PiStorm/cm4board/README.md

# CM4 Adapter for PiStorm32-Lite and PiStorm

This repository contains the hardware design for RaspberryPi Compute Module 4 Adapter designed especially for PiStorm32-Lite and PiStorm32 Amiga accelerators. Please note the CM4 adapter for PiStorm is not ready yet, only the PiStorm32-Lite version is usable.
