PiStorm/cm4board/CM4_PiStorm32Lite/FabricationData/PiStorm32L_IO_Trapdoor.stl

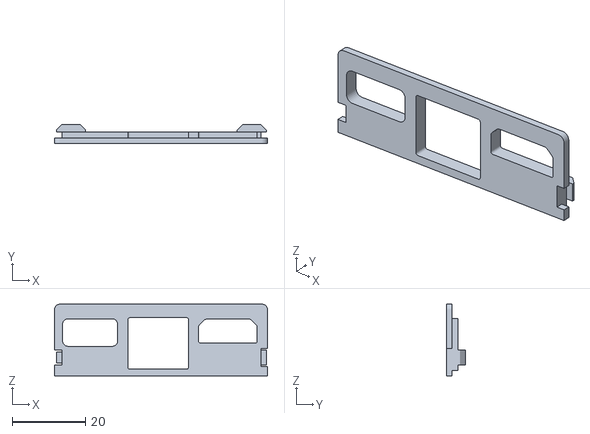
[picture p5: CAD file, 2024-01-28]
CM4_PiStorm32Lite/FabricationData/PiStorm32L_IO_Trapdoor.stl
58.0 x 5.15 x 19.5
