PiStorm/cm4board/CM4_PiStorm32Lite/FabricationData/CM4_PiStorm32Lite_Spacer.stl

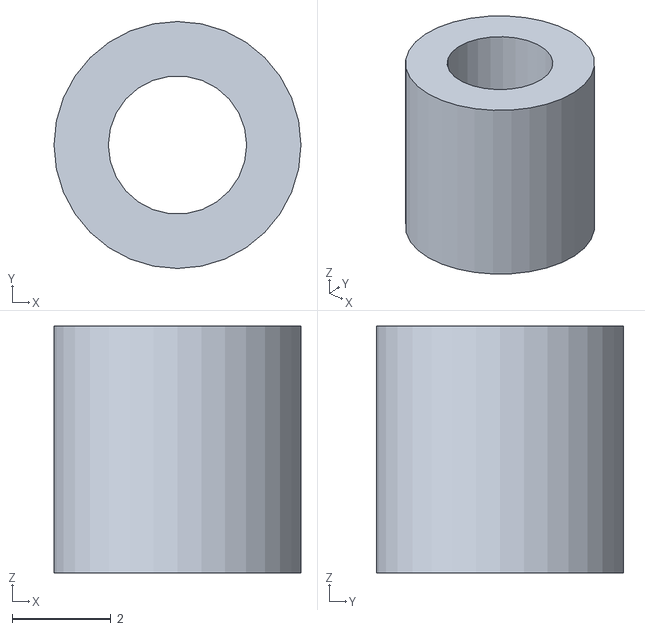
[picture p6: CAD file, 2023-03-12]
CM4_PiStorm32Lite/FabricationData/CM4_PiStorm32Lite_Spacer.stl
5.00 x 5.00 x 5.00
