PiStorm/cm4board/CM4_PiStorm32Lite/FabricationData/CM4_PiStorm32Lite_Schematic.pdf

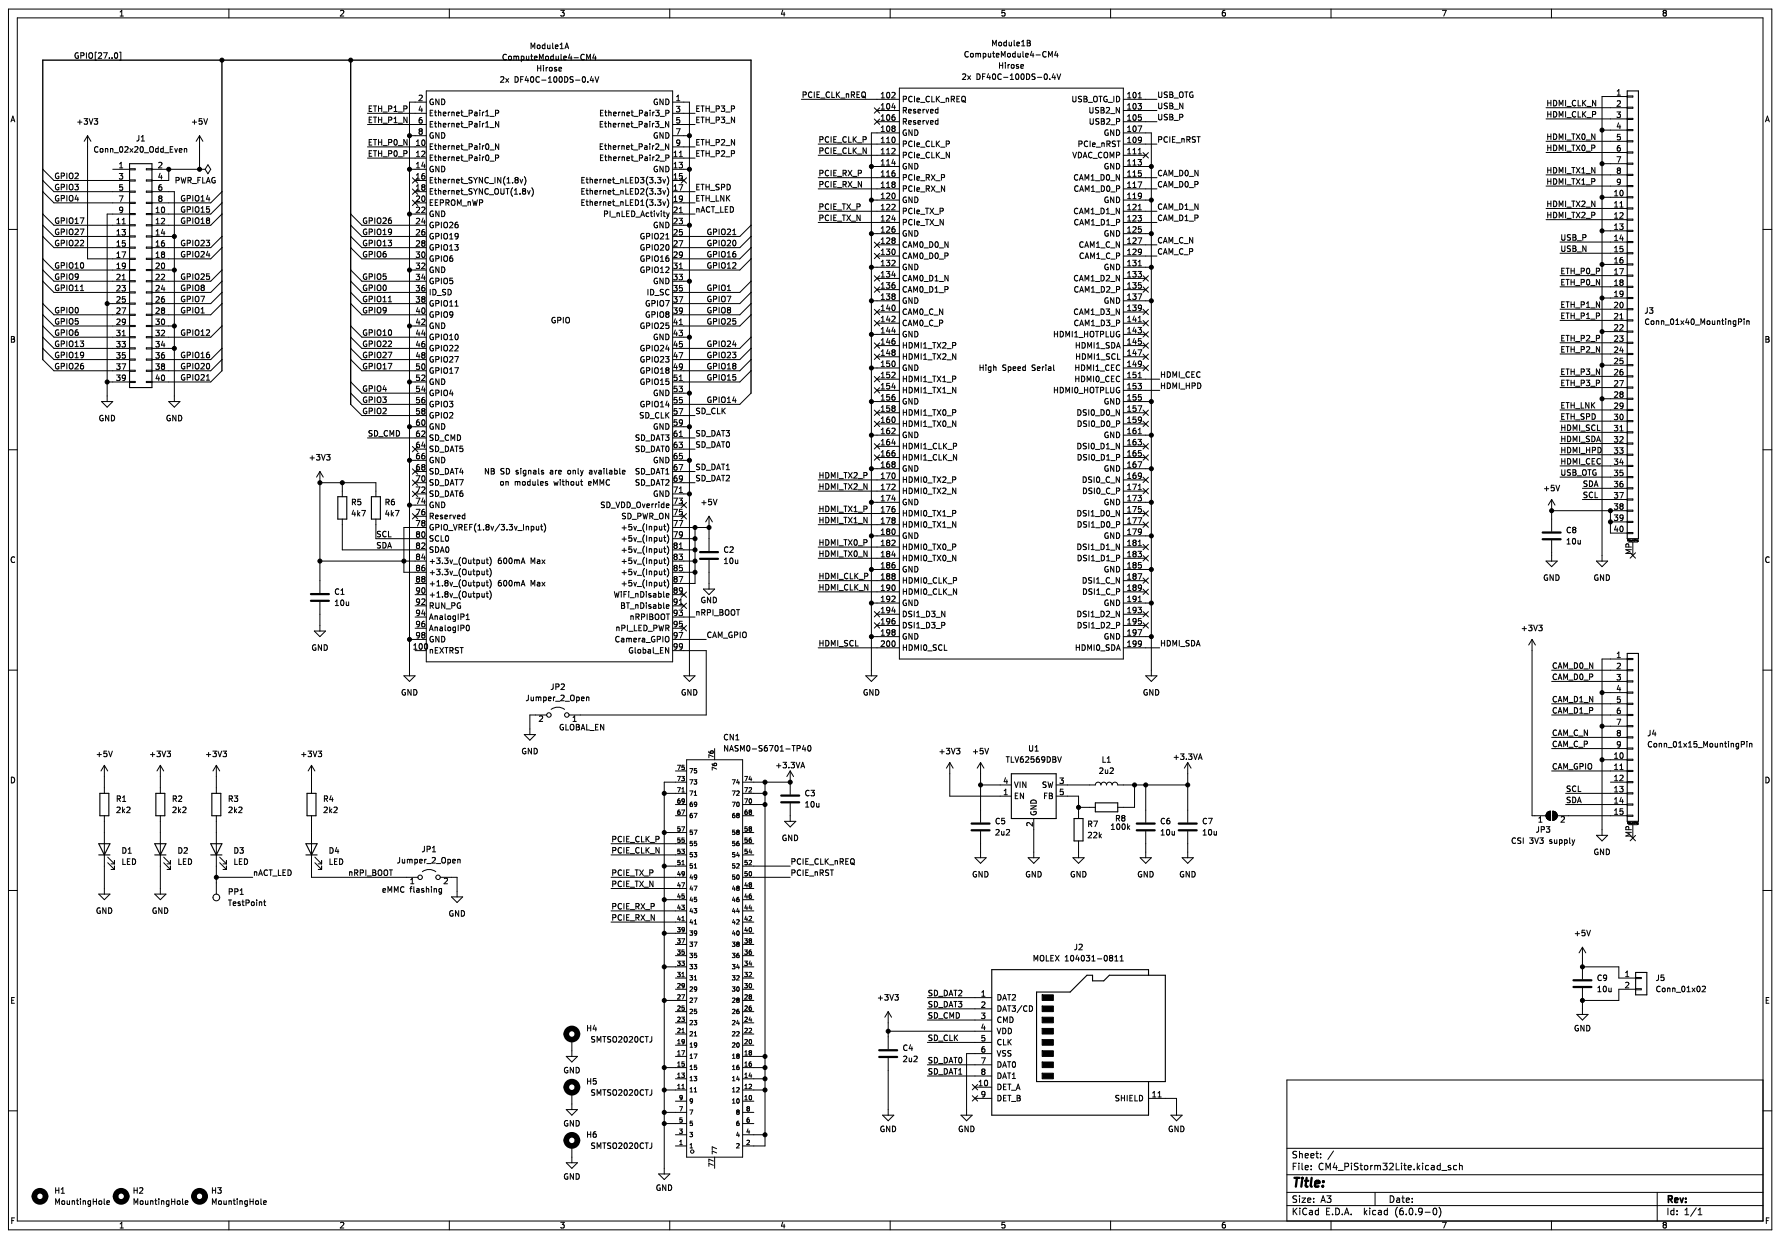
[picture p7: page 1]
