PiStorm/cm4board/(commit log)

2022-12-31 two empty projects, one for CM4 PiStorm and another one for fully featured CM4 for PiStorm32Lite
    [CM4_PiStorm.kicad_pcb, CM4_PiStorm.kicad_sch, CM4_PiStorm32Lite.kicad_pcb, CM4_PiStorm32Lite.kicad_sch]
2022-12-31 git ignore file for kicad projects
2023-01-01 schematic and board updated a little
    [CM4_PiStorm32Lite.kicad_pcb, CM4_PiStorm32Lite.kicad_sch]
2023-01-01 updated schematic and layout. A lot of stuff still missing though
    [CM4_PiStorm32Lite.kicad_pcb, CM4_PiStorm32Lite.kicad_sch]
2023-01-05 WiP update
    [CM4_PiStorm32Lite.kicad_pcb, CM4_PiStorm32Lite.kicad_sch]
2023-01-07 add KeepOut zone where PiStorm32-lite is sitting
    [CM4_PiStorm32Lite.kicad_pcb]
2023-01-08 added 3d models of microSD connectors
2023-01-08 added microSD footprints available at JLCPCB
2023-01-08 added custom footprint library
2023-01-08 WiP - microSD updated
    [CM4_PiStorm32Lite.kicad_pcb, CM4_PiStorm32Lite.kicad_sch]
2023-01-08 Paths for step files updated to project-relative
    [CM4_PiStorm32Lite.kicad_pcb]
2023-01-09 small geometry fixes, added OSHW logo and PROG led
    [CM4_PiStorm32Lite.kicad_pcb, CM4_PiStorm32Lite.kicad_sch]
2023-01-09 added 40-pin FPC bottom side to the library
2023-01-09 Updates, WiP, removed USB, added some silkscreen
    [CM4_PiStorm32Lite.kicad_pcb, CM4_PiStorm32Lite.kicad_sch]
2023-01-10 custom library updates - new connectors and threads
2023-01-10 WiP update - NVME connector and routing
    [CM4_PiStorm32Lite.kicad_pcb, CM4_PiStorm32Lite.kicad_sch]
2023-01-10 WiP, mostly routed, check phase
    [CM4_PiStorm32Lite.kicad_pcb, CM4_PiStorm32Lite.kicad_sch]
2023-01-11 DRC reviewed. 0 errors, few silkscreen warnings
    [CM4_PiStorm32Lite.kicad_pcb, CM4_PiStorm32Lite.kicad_sch]
2023-01-11 C103 moved to back, silkscreen slightly updated
    [CM4_PiStorm32Lite.kicad_pcb]
2023-01-12 Reassigned designator numbers, added LCSC part numbers
    [CM4_PiStorm32Lite.kicad_pcb, CM4_PiStorm32Lite.kicad_sch]
2023-01-12 Added jumper place for GLOBAL_EN (PMIC Shutdown/Startup)
    [CM4_PiStorm32Lite.kicad_pcb, CM4_PiStorm32Lite.kicad_sch]
2023-01-12 Final touch
    [CM4_PiStorm32Lite.kicad_pcb, CM4_PiStorm32Lite.kicad_sch]
2023-01-26 PP1 renamed back to PP13. R8 changed to 100k
    [CM4_PiStorm32Lite.kicad_pcb, CM4_PiStorm32Lite.kicad_sch]
2023-02-13 updated fab data
    [CM4_PiStorm32Lite.csv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]
2023-02-13 added amount of space to be optimized
    [CM4_PiStorm32Lite.kicad_pcb]
2023-02-13 v1.1 B-Day edition changes
    [CM4_PiStorm32Lite.kicad_pcb, CM4_PiStorm32Lite.kicad_sch]
2023-02-14 Added 3v3 jumper for CSI
    [CM4_PiStorm32Lite.kicad_pcb, CM4_PiStorm32Lite.kicad_sch]
2023-02-14 I2C on CSI port swapped
    [CM4_PiStorm32Lite.kicad_pcb, CM4_PiStorm32Lite.kicad_sch]
2023-02-14 Replaced designator with fixed PP13 text
    [CM4_PiStorm32Lite.kicad_pcb]
2023-02-14 Designator numbering updated once again...
    [CM4_PiStorm32Lite.kicad_pcb, CM4_PiStorm32Lite.kicad_sch]
2023-02-20 production files updated
    [CM4_PiStorm32Lite.csv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]
2023-02-20 last updates
    [CM4_PiStorm32Lite.kicad_pcb, CM4_PiStorm32Lite.kicad_sch]
2023-02-20 added schematic of CM4 Adapter
2023-03-12 Readme and assembly instructions for CM4 Adapter for PS32Lite
    [CM4_PiStorm32Lite_Spacer.stl]
2023-03-17 Added warning regarding fixing CM4 and heatsink
2024-01-28 Trapdoor STL added
    [PiStorm32L_IO_Trapdoor.stl]
